avrech/ball_on_plate_balancing/images/the-system.png

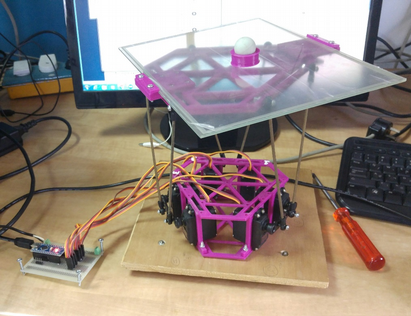
images/the-system.png
